jojotown-eng/mouse-robot/README.md

# mouse-robot
マイクロマウスで使用するデータを入れておくリポジトリ

### design
機体のcadデータを入れるファイル

### firmware
マウス内のプログラムデータを入れるフォルダ

### PCB
基板関連のデータを入れる
