jojotown-eng/mouse-robot/参考資料/4fe2ce75dccb81fe/マニュアル(途中)/プログラミングの実践応用編.pptx

## プログラミング

実践応用編

## ＋α

- 安定性の向上
壁切れでの補正
前壁制御
横壁による後offset補正
- 探索や最短走行をより早く
歩数マップの直進優先
パス圧縮(大回り)
パス圧縮(斜め走行)
既知区間加速
- わかりやすく便利に
ファイルの分割
構造体
モード決定の関数
Flashに壁情報を保存

## 安定性向上

## 安定性の向上 :壁切れでの補正

壁の切れ目を判定してターン前のoffsetを調整
壁が切れるまで進む→壁が切れたらそこから任意の距離進む
距離が足りない場合は壁が切れるまで進むで距離を増加させ、
距離が過ぎてる場合は壁が切れてからの距離のため距離が減少させる．

## 安定性の向上 :前壁制御

前センサの値を前壁との距離に変換し，一定の距離になったら曲がる

## 安定性の向上 :前壁制御

横センサの値を横壁との距離に変換し，その距離に応じて後オフセットの距離を変化させる

## 探索や最短走行をより早く

## Slide 8
