jojotown-eng/mouse-robot/参考資料/4fe2ce75dccb81fe/マニュアル(途中)/番外編_シルクでお絵かき.pptx

## 番外編

## Slide 2

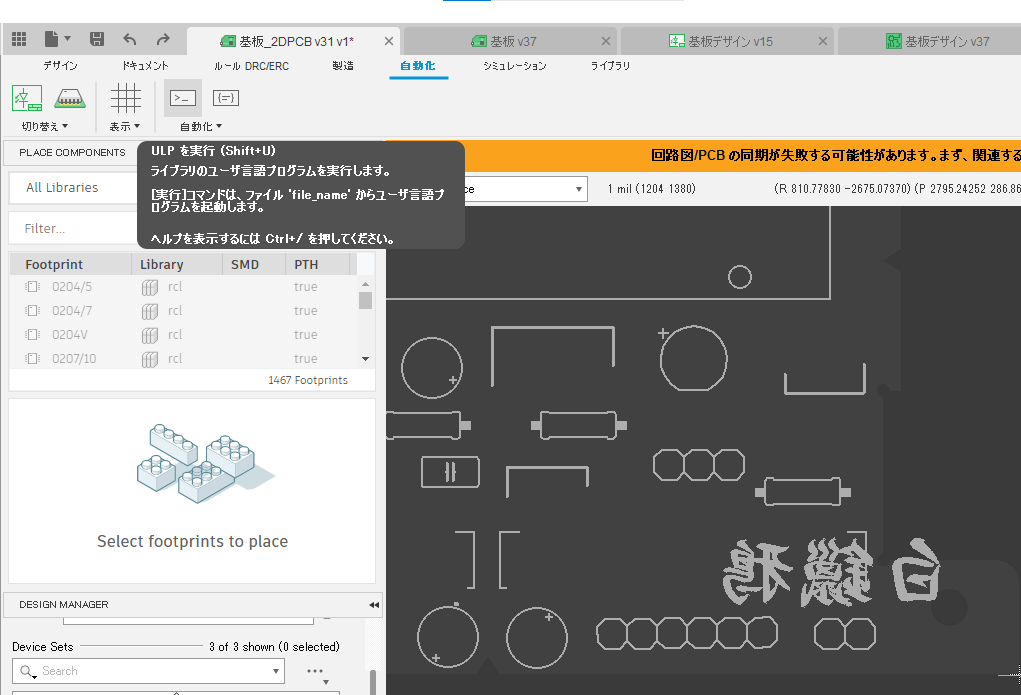
[picture p2: figure]

## Slide 3

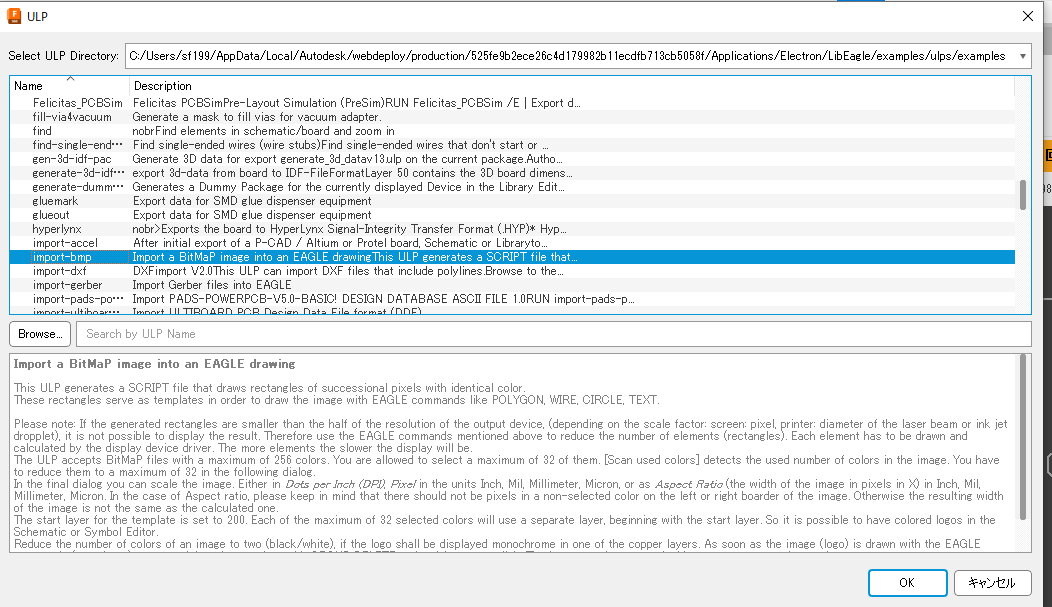
[picture p3: figure]

## Slide 4

二値化ファイル(BMP)を開く

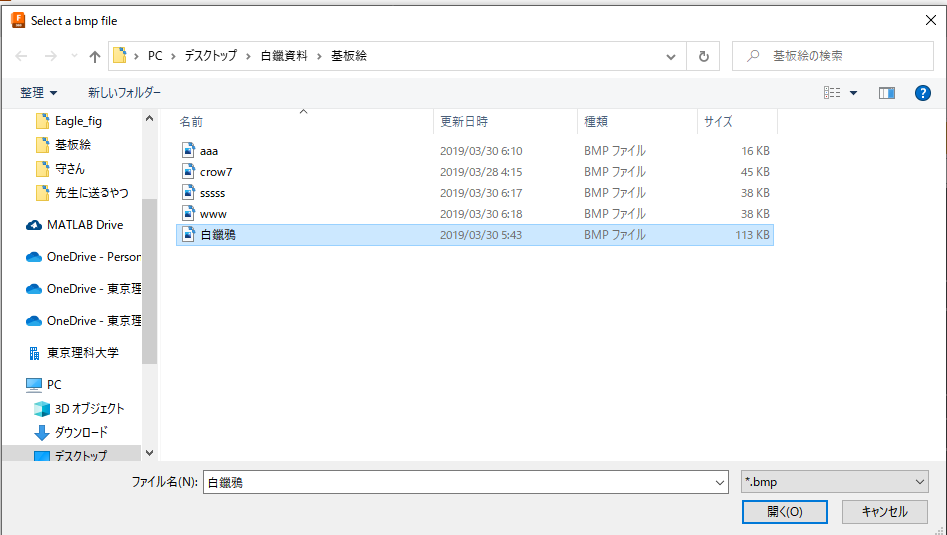
[picture p4: figure]

## Slide 5

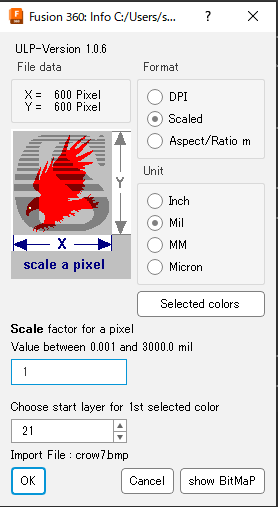
[picture p5: figure]

シルクを入れたい色を選ぶ

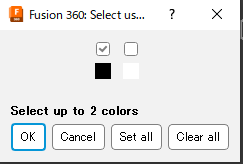
[picture p6: figure]

スケール(大きさ)
絵を入れるレイヤー(今回は表面ならtplaceの21,裏面ならbplaceの22)

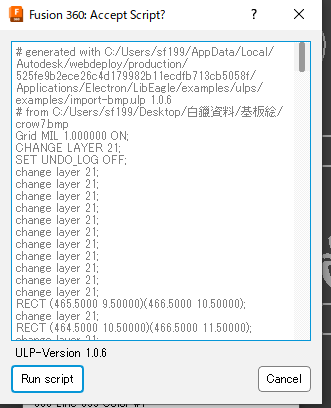
[picture p7: figure]

run
