jojotown-eng/mouse-robot/参考資料/下基板.dxf

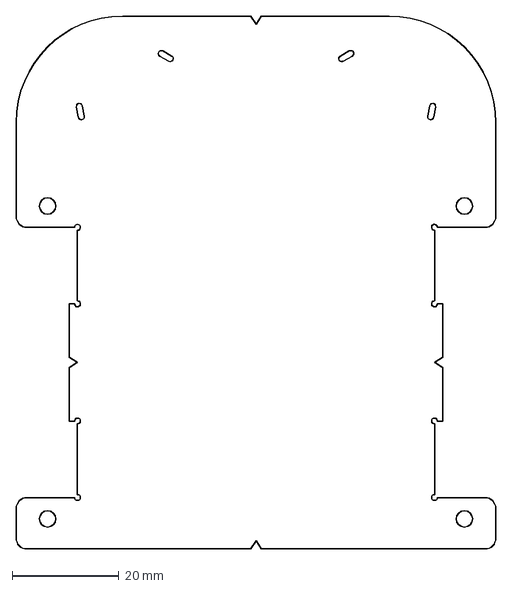
[picture p17: CAD file, 2024-09-20]
参考資料/下基板.dxf
90.0 x 100.0 mm
