jojotown-eng/mouse-robot/(list of files, cad)

Other CAD files:
参考資料/316592fce7f853e4.f3z
