jojotown-eng/mouse-robot/参考資料/v1.pdf

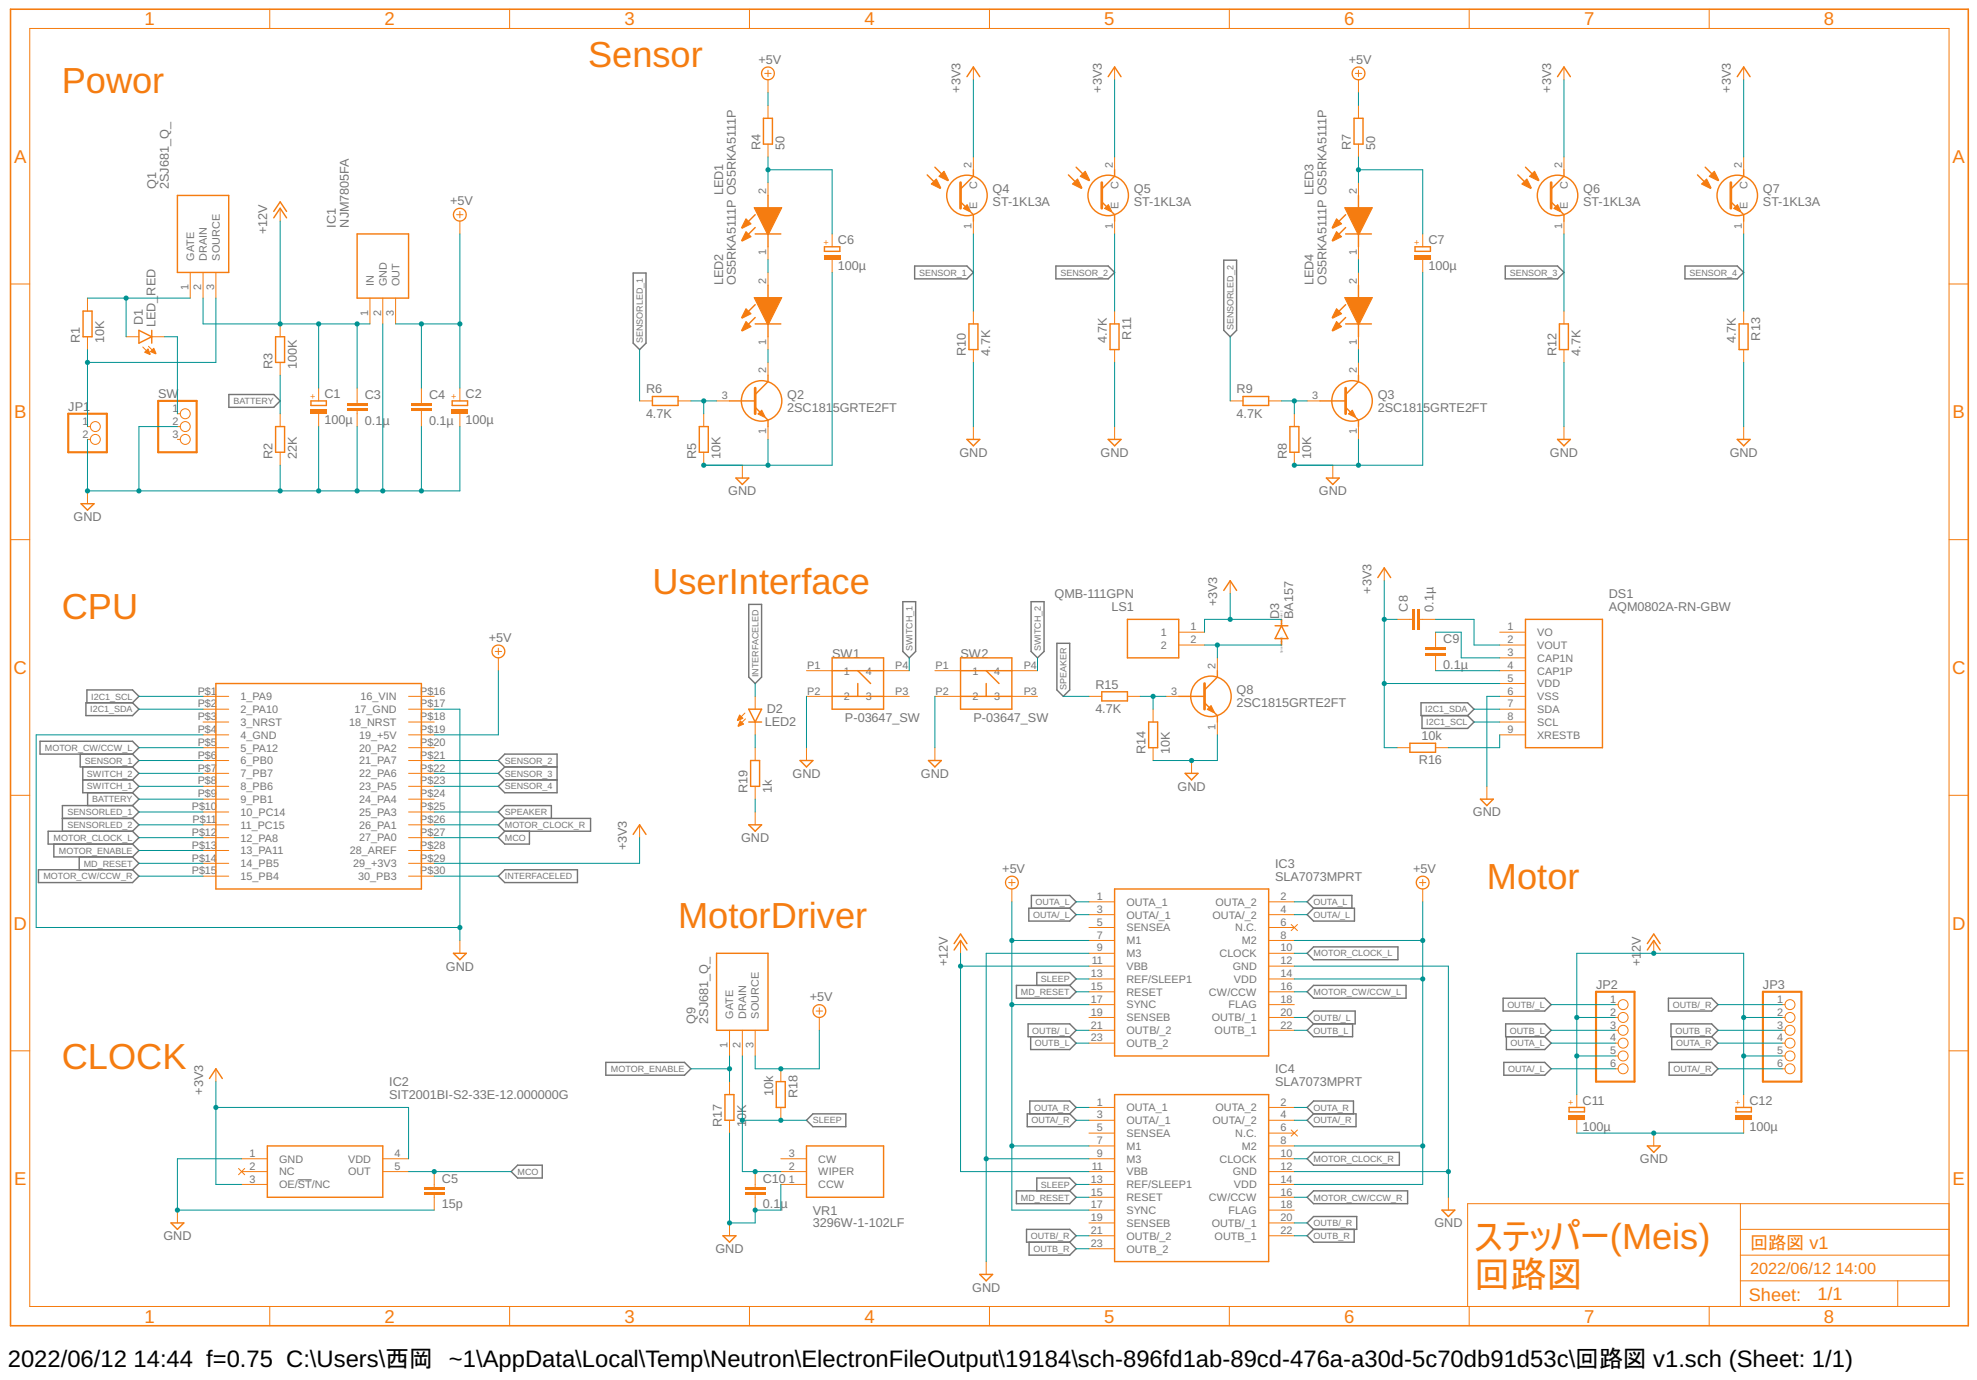
[picture p18: page 1]

Sensor +5V | | | +5V

2022/06/12 14:44 f=0.75 C:\Users\西岡 ~1\AppData\Local\Temp\Neutron\ElectronFileOutput\19184\sch-896fd1ab-89cd-476a-a30d-5c70db91d53c\回路図 v1.sch (Sheet: 1/1)
