jojotown-eng/mouse-robot/PCB/mouse_v1/mouse_v1.kicad_pcb

## KiCad design PCB/mouse_v1/mouse_v1.kicad_pcb (2024-11-23)

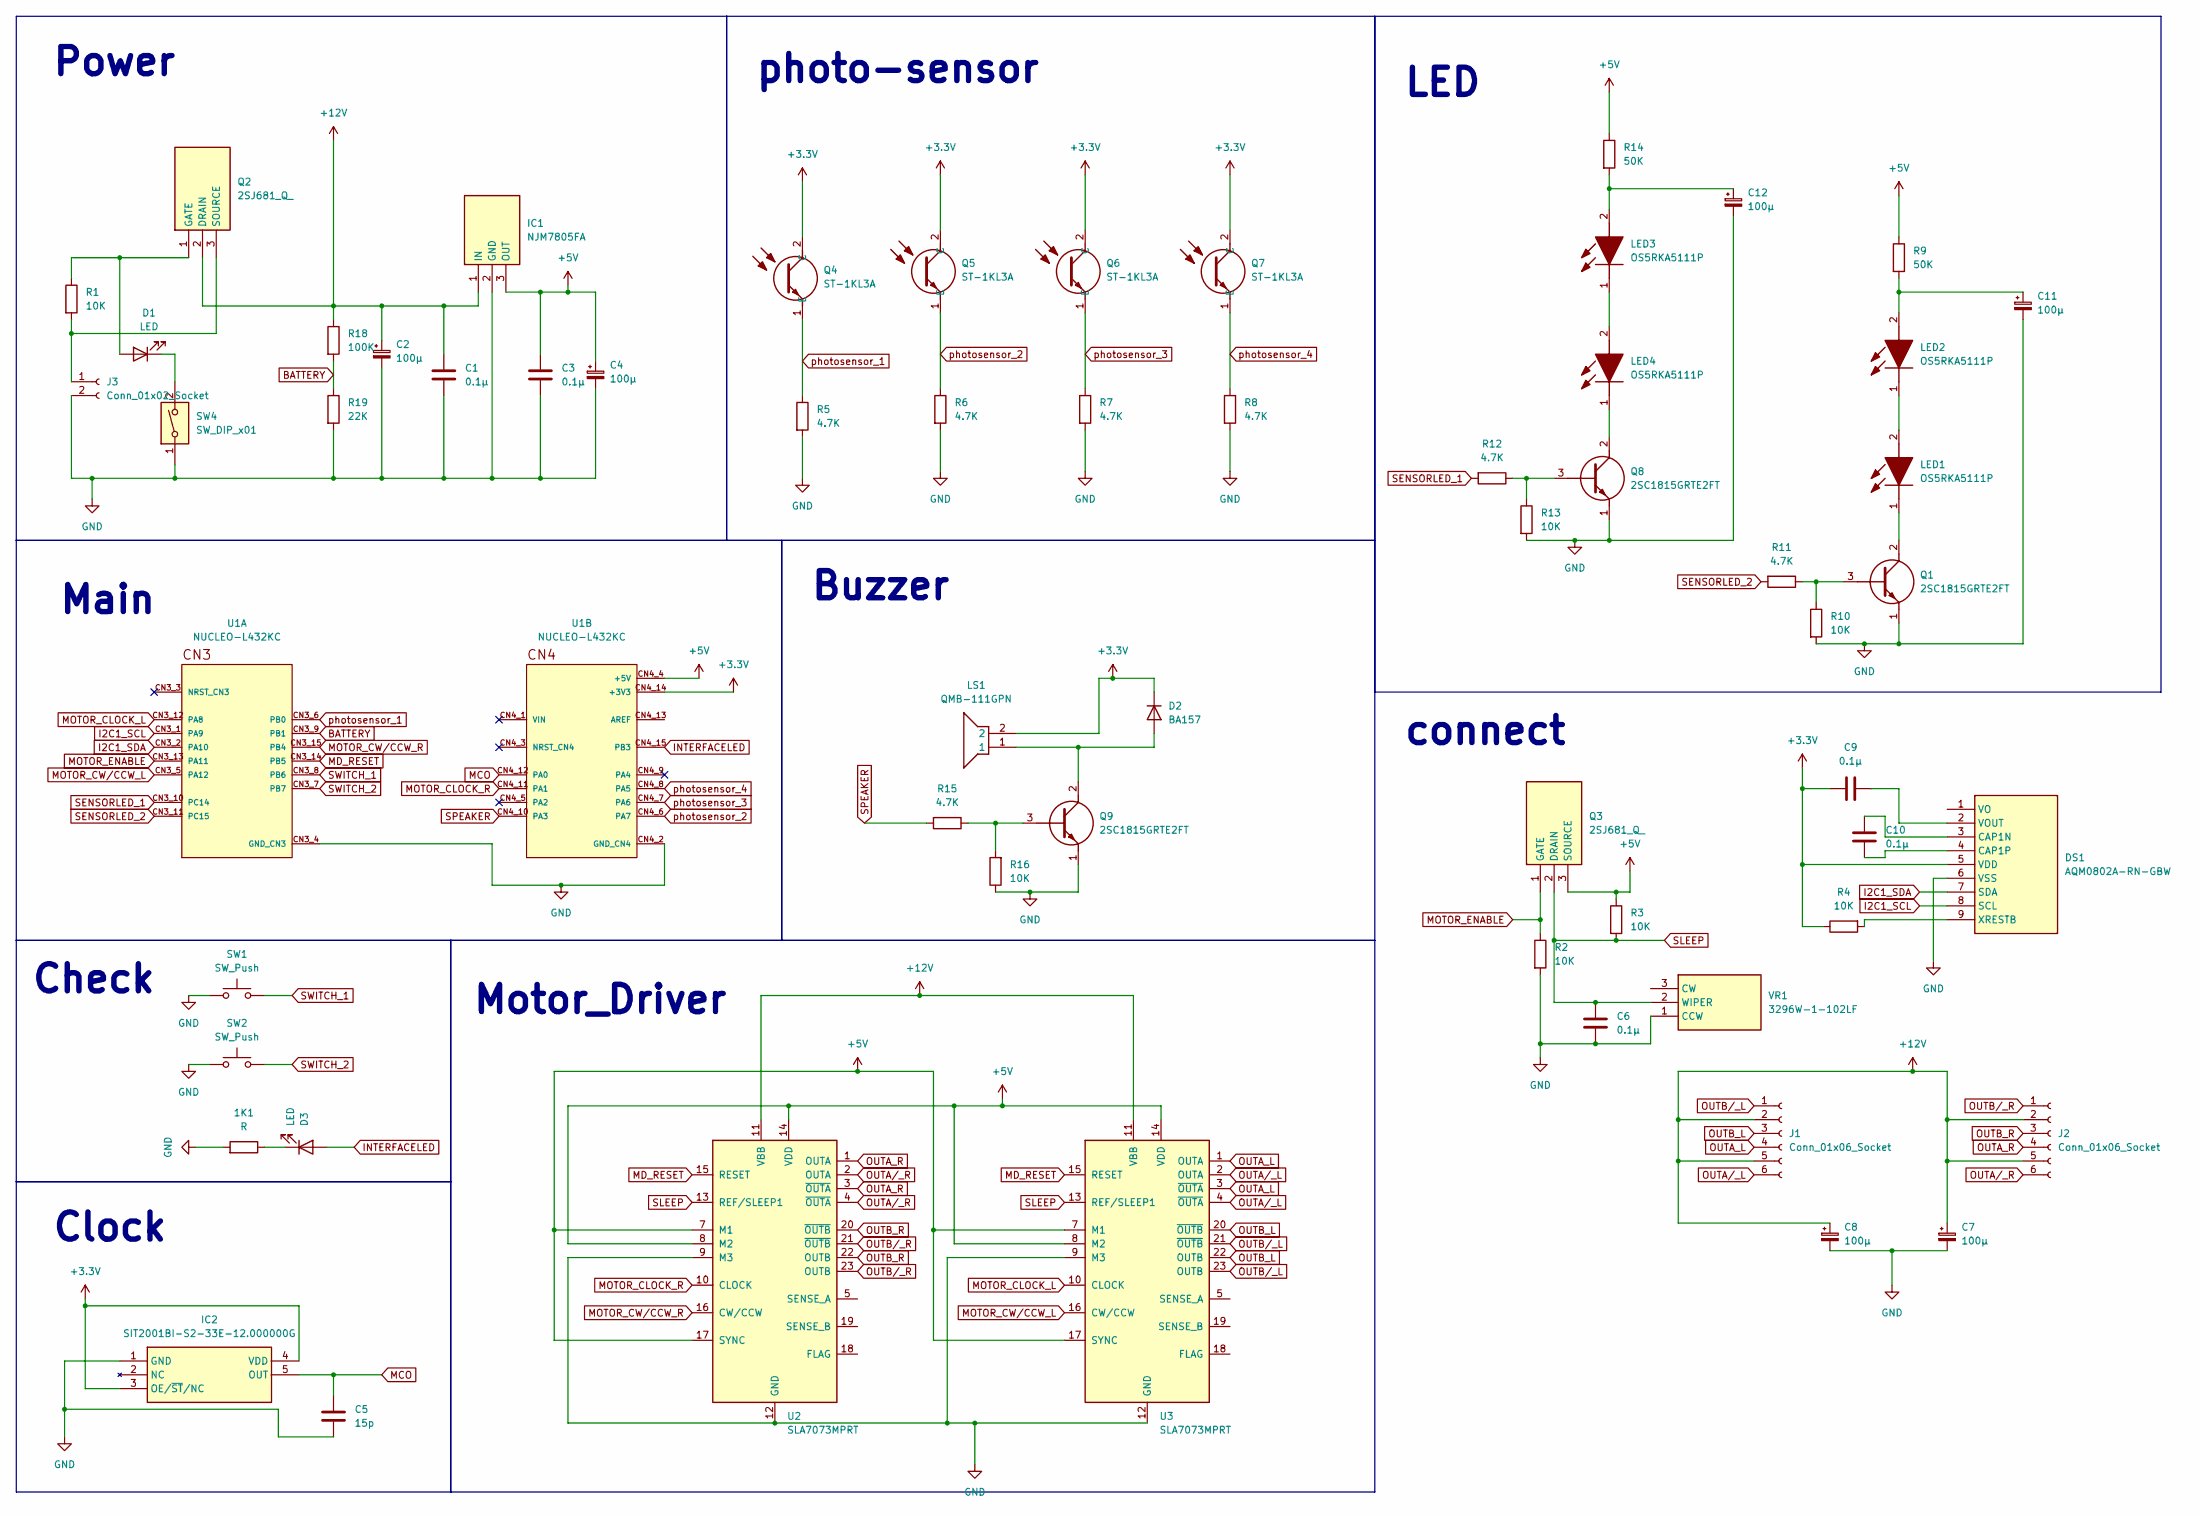
[picture p19: schematic mouse_v1.kicad_sch]

Parts:
1K1: R; R_0603_1608Metric_Pad0.98x0.95mm_HandSolder
C1, C3, C6, C9, C10: 0.1μ; C_0603_1608Metric
C2, C4, C7, C8, C11, C12: 100μ; CP_Radial_D6.3mm_P2.50mm
C5: 15p; C_0603_1608Metric
D1, D3: LED; LED_0603_1608Metric
D2: BA157; D_0603_1608Metric
DS1: AQM0802A-RN-GBW; AQM0802ARNGBW; Manufacturer_Part_Number AQM0802A-RN-GBW
IC1: NJM7805FA; TO254P500X1000X2170-3P; Manufacturer_Part_Number NJM7805FA
IC2: SIT2001BI-S2-33E-12.000000G; SOT95P280X130-5N; Manufacturer_Part_Number SIT2001BI-S2-33E-12.000000G
J1, J2: Conn_01x06_Socket; JST_XH_B6B-XH-A_1x06_P2.50mm_Vertical
J3: Conn_01x02_Socket; JST_XH_B2B-XH-A_1x02_P2.50mm_Vertical
LED1, LED2, LED3, LED4: OS5RKA5111P; Manufacturer_Part_Number OS5RKA5111P
LS1: QMB-111GPN; QMB111GPN; Manufacturer_Part_Number QMB-111GPN
Q1, Q8, Q9: 2SC1815GRTE2FT; SOT-23; Manufacturer_Part_Number 2SC1815GRTE2FT
Q2, Q3: 2SJ681_Q_; TO230P250X650X900-3P; Manufacturer_Part_Number 2SJ681(Q)
Q4, Q5, Q6, Q7: ST-1KL3A; ST1KL3A; Manufacturer_Part_Number ST-1KL3A
R1, R2, R3, R4, R10, R13, R16: 10K; R_0603_1608Metric_Pad0.98x0.95mm_HandSolder
R5, R6, R7, R8, R11, R12, R15: 4.7K; R_0603_1608Metric_Pad0.98x0.95mm_HandSolder
R9, R14: 50K; R_0603_1608Metric_Pad0.98x0.95mm_HandSolder
R18: 100K; R_0603_1608Metric_Pad0.98x0.95mm_HandSolder
R19: 22K; R_0603_1608Metric_Pad0.98x0.95mm_HandSolder
SW1, SW2: SW_Push; SW_PUSH_6mm_H7.3mm
SW4: SW_DIP_x01; SW_DIP_SPSTx01_Slide_9.78x4.72mm_W7.62mm_P2.54mm
U1: NUCLEO-L432KC; MODULE_NUCLEO-L432KC; PARTREV N/A
U2, U3: SLA7073MPRT
VR1: 3296W-1-102LF; 3296W1102LF; Manufacturer_Part_Number 3296W-1-102LF

Connections:
+3.3V: C9.1, D2.1 (K), DS1.5 (VDD), IC2.3 (OE/~ST/NC), IC2.4 (VDD), LS1.2, Q4.2 (C), Q5.2 (C), Q6.2 (C), Q7.2 (C), R4.1, U1.CN4_14 (+3V3)
+5V: C3.1, C4.1, IC1.3 (OUT), Q3.3 (SOURCE), R3.1, R9.1, R14.1, U1.CN4_4 (+5V), U2.7 (M1), U2.8 (M2), U2.14 (VDD), U2.17 (SYNC), U3.7 (M1), U3.8 (M2), U3.14 (VDD), U3.17 (SYNC)
+12V: C1.1, C2.1, C7.1, C8.1, IC1.1 (IN), J1.2, J1.5, J2.2, J2.5, Q2.2 (DRAIN), R18.1, U2.11 (VBB), U3.11 (VBB)
BATTERY: R18.2, R19.1, U1.CN3_9 (PB1)
GND: 1K1.2, C1.2, C2.2, C3.2, C4.2, C5.2, C6.2, C7.2, C8.2, C11.2, C12.2, DS1.6 (VSS), IC1.2 (GND), IC2.1 (GND), J3.2, Q1.1 (E), Q8.1 (E), Q9.1 (E), R2.2, R5.2, R6.2, R7.2, R8.2, R10.2, R13.2, R16.1, R19.2, SW1.1, SW2.1, SW4.1, U1.CN3_4 (GND_CN3), U1.CN4_2 (GND_CN4), U2.9 (M3), U2.12 (GND), U3.9 (M3), U3.12 (GND), VR1.1 (CCW)
I2C1_SCL: DS1.8 (SCL), U1.CN3_1 (PA9)
I2C1_SDA: DS1.7 (SDA), U1.CN3_2 (PA10)
INTERFACELED: D3.2 (A), U1.CN4_15 (PB3)
MCO: C5.1, IC2.5 (OUT), U1.CN4_12 (PA0)
MD_RESET: U1.CN3_14 (PB5), U2.15 (RESET), U3.15 (RESET)
MOTOR_CLOCK_L: U1.CN3_12 (PA8), U3.10 (CLOCK)
MOTOR_CLOCK_R: U1.CN4_11 (PA1), U2.10 (CLOCK)
MOTOR_CW/CCW_L: U1.CN3_5 (PA12), U3.16 (CW/CCW)
MOTOR_CW/CCW_R: U1.CN3_15 (PB4), U2.16 (CW/CCW)
MOTOR_ENABLE: Q3.1 (GATE), R2.1, U1.CN3_13 (PA11)
unnamed: D1.2 (A), Q2.1 (GATE), R1.1
unnamed: D1.1 (K), SW4.2
unnamed: D2.2 (A), LS1.1, Q9.2 (C)
unnamed: 1K1.1, D3.1 (K)
unnamed: C10.2, DS1.3 (CAP1N)
unnamed: C10.1, DS1.4 (CAP1P)
unnamed: C9.2, DS1.2 (VOUT)
unnamed: DS1.9 (XRESTB), R4.2
unnamed: J3.1, Q2.3 (SOURCE), R1.2
unnamed: LED1.2 (A), LED2.1 (K)
unnamed: LED1.1 (K), Q1.2 (C)
unnamed: C11.1, LED2.2 (A), R9.2
unnamed: C12.1, LED3.2 (A), R14.2
unnamed: LED3.1 (K), LED4.2 (A)
unnamed: LED4.1 (K), Q8.2 (C)
unnamed: Q1.3 (B), R10.1, R11.1
unnamed: Q8.3 (B), R12.1, R13.1
unnamed: Q9.3 (B), R15.1, R16.2
OUTA_L: J1.4, U3.1 (OUTA), U3.3 (~OUTA)
OUTA_R: J2.4, U2.1 (OUTA), U2.3 (~OUTA)
OUTA/_L: J1.6, U3.2 (OUTA), U3.4 (~OUTA)
OUTA/_R: J2.6, U2.2 (OUTA), U2.4 (~OUTA)
OUTB_L: J1.3, U3.20 (~OUTB), U3.22 (OUTB)
OUTB_R: J2.3, U2.20 (~OUTB), U2.22 (OUTB)
OUTB/_L: J1.1, U3.21 (~OUTB), U3.23 (OUTB)
OUTB/_R: J2.1, U2.21 (~OUTB), U2.23 (OUTB)
SENSORLED_1: R12.2, U1.CN3_10 (PC14)
SENSORLED_2: R11.2, U1.CN3_11 (PC15)
SLEEP: C6.1, Q3.2 (DRAIN), R3.2, U2.13 (REF/SLEEP1), U3.13 (REF/SLEEP1), VR1.2 (WIPER)
SPEAKER: R15.2, U1.CN4_10 (PA3)
SWITCH_1: SW1.2, U1.CN3_8 (PB6)
SWITCH_2: SW2.2, U1.CN3_7 (PB7)
photosensor_1: Q4.1 (E), R5.1, U1.CN3_6 (PB0)
photosensor_2: Q5.1 (E), R6.1, U1.CN4_6 (PA7)
photosensor_3: Q6.1 (E), R7.1, U1.CN4_7 (PA6)
photosensor_4: Q7.1 (E), R8.1, U1.CN4_8 (PA5)

Notes on the sheet:
photo-sensor
Check
Power
connect
Buzzer
Motor_Driver
Main
LED
Clock

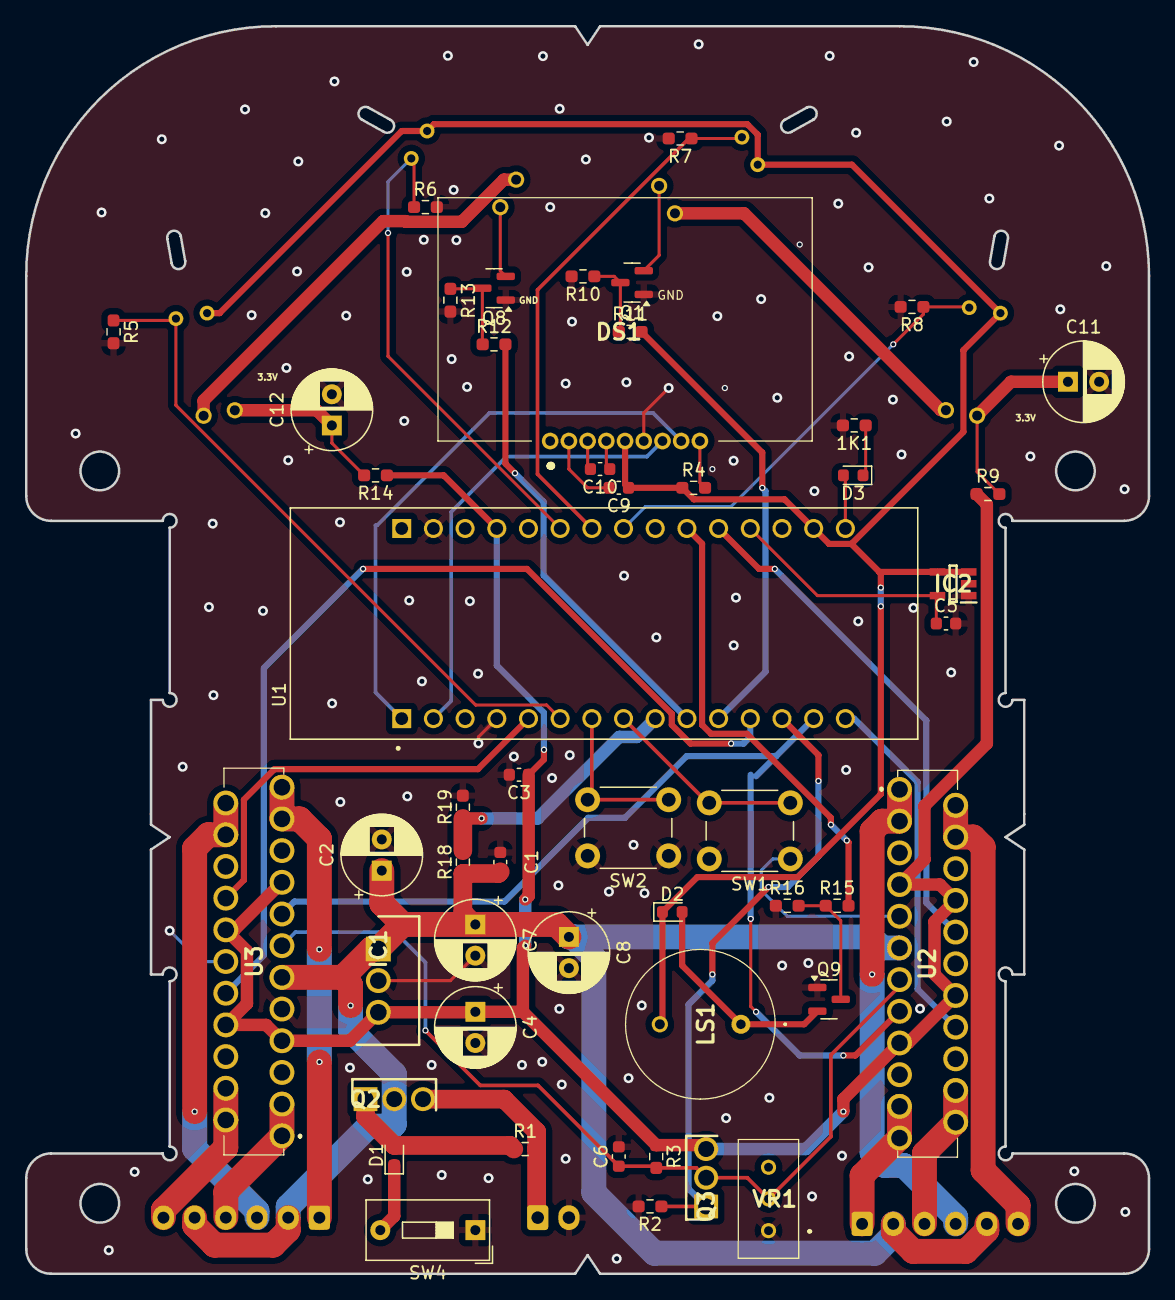
[picture p20: board mouse_v1.kicad_pcb from above]

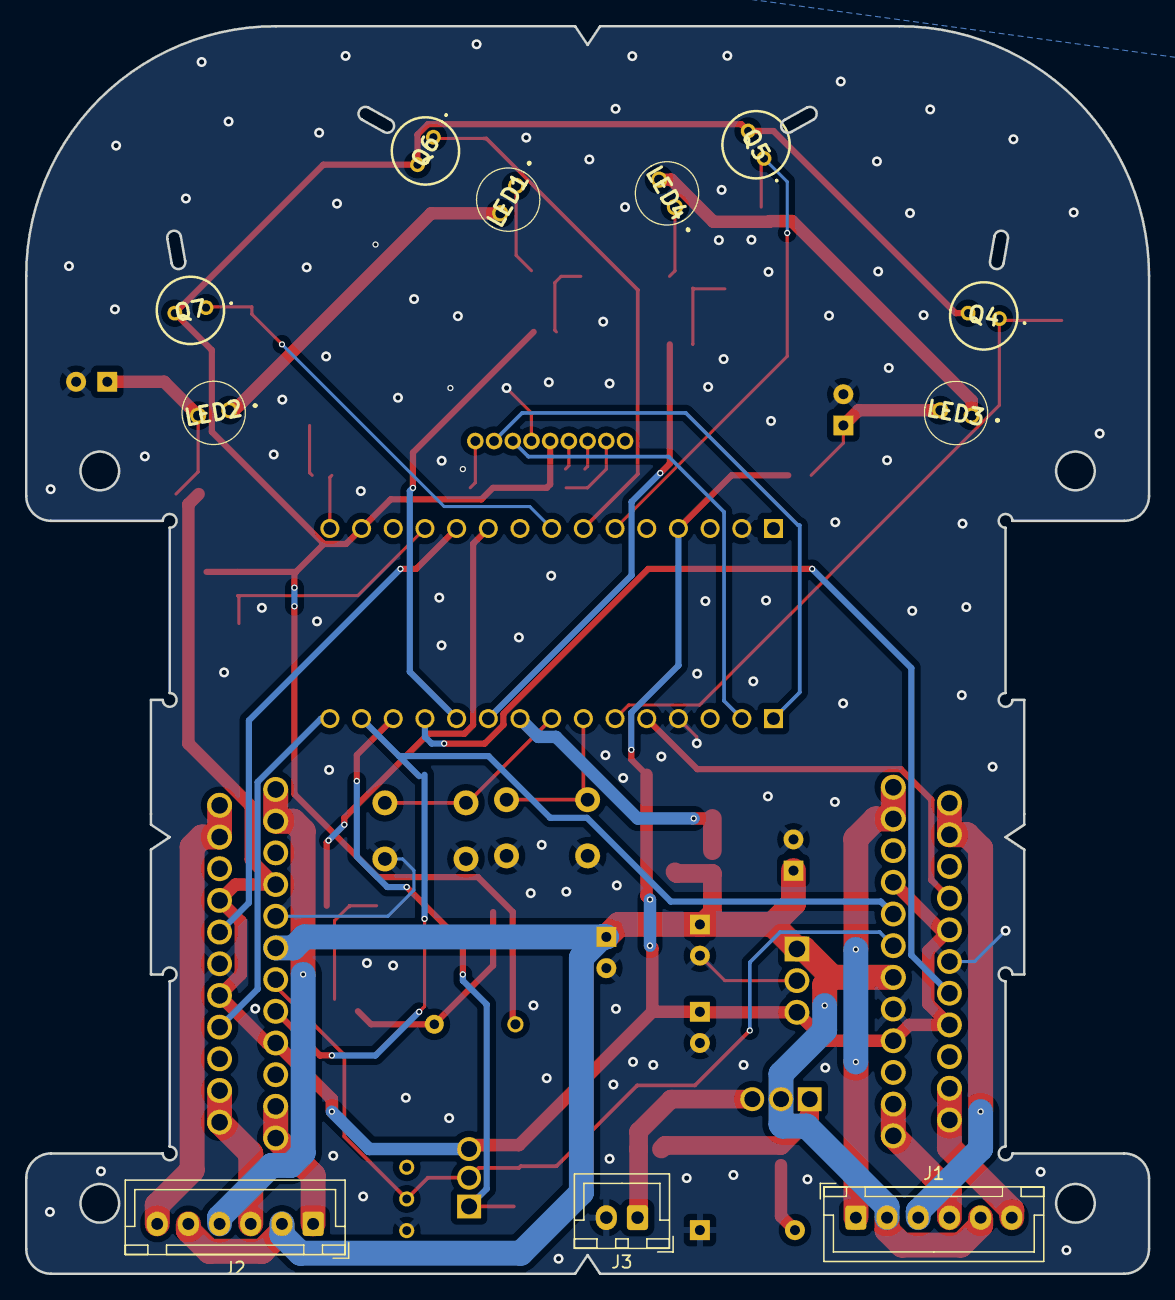
[picture p21: board mouse_v1.kicad_pcb from below]

Board: 2 copper layers, 90.0 x 100.0 mm, 61 parts (11 on the bottom side), 51 nets.
