jojotown-eng/mouse-robot/firmware/firmware.ioc

Mcu.UserName=STM32L432KCUx
PA10.GPIO_Label=switch
PA10.Signal=GPIO_Input
PA11.Signal=CAN1_RX
PA12.Signal=CAN1_TX
PA2.Signal=USART2_TX
PA3.Signal=USART2_RX
PA8.Signal=SWPMI1_IO
PA9.Signal=GPIO_Output
