jojotown-eng/mouse-robot/firmware/Core/Inc/main.h

#define switch_Pin GPIO_PIN_10
#define switch_GPIO_Port GPIOA
#define LED_Pin GPIO_PIN_3
#define LED_GPIO_Port GPIOB
