jojotown-eng/mouse-robot/firmware/include/mainpp.h

#ifndef BURGER_COOKER_DC_MOTOR_DIVER_APP_APP_H_
#define BURGER_COOKER_DC_MOTOR_DIVER_APP_APP_H_

#ifdef __cplusplus
extern "C" {
#endif

#include "main.h"

void mainsetup(void);
void maintask(void);

#ifdef __cplusplus
}
#endif 

#endif //BURGER_COOKER_DC_MOTOR_DIVER_APP_APP_H_
