jojotown-eng/mouse-robot/(commit log)

2024-08-22 Kicadの新規ファイル追加
    [mouse_v1.kicad_pcb, mouse_v1.kicad_sch]
2024-08-22 soramouse参考プログラム
2024-08-22 須田先輩から頂いた資料
    [316592fce7f853e4.f3z]
2024-08-25 フットプリントライブラリーの追加
2024-08-31 main,motor_driver,connect,clockの回路図作成
    [mouse_v1.kicad_sch]
2024-09-05 回路図のデータ作成終了,名前振り開始
    [mouse_v1.kicad_sch]
2024-09-09 回路図の名前振り終了
    [mouse_v1.kicad_sch]
2024-09-09 capactorを適当にフットプリント振った
    [mouse_v1.kicad_sch]
2024-09-19 フットプリントを途中まで割り当てて,外部からインポートした部品はできていない
    [mouse_v1.kicad_pcb, mouse_v1.kicad_sch]
2024-09-20 基板のフットプリント完了
    [mouse_v1.kicad_pcb, mouse_v1.kicad_sch, 下基板.dxf]
2024-09-20 READMEの編集を行った
2024-09-22 抵抗やコンデンサに具体的な値を明示した
    [mouse_v1.kicad_sch]
2024-09-23 配線完了,元のデータはsensorLEDのフラグの値が両方1になっていた
    [mouse_v1.kicad_pcb]
2024-09-23 README少し変更した
2024-09-28 アートワークを部品ごとに区分けした
    [mouse_v1.kicad_pcb]
2024-09-28 配線が短くなるように配線した,I2Cは長くなった
    [mouse_v1.kicad_pcb]
2024-09-28 配線完了した(埋め込んだcadがおかしいかも)
    [mouse_v1.kicad_pcb]
2024-09-30 穴の位置に備品があったから少し配置を変えた
    [mouse_v1.kicad_pcb]
2024-10-03 残りのコミット
2024-11-09 配線完了(仮)
    [mouse_v1.kicad_pcb, mouse_v1.kicad_sch]
2024-11-09 基板完成
    [mouse_v1.kicad_pcb]
2024-11-09 未配線部分を配線した
2024-11-18 再配線完了
    [mouse_v1.kicad_pcb]
2024-11-23 LEDのコンデンサ部分の配線を太くした
    [mouse_v1-B_Paste.gbr, mouse_v1-B_Silkscreen.gbr, mouse_v1-Edge_Cuts.gbr, mouse_v1-F_Paste.gbr, mouse_v1-F_Silkscreen.gbr, mouse_v1-NPTH.drl, mouse_v1-PTH.drl, mouse_v1-job.gbrjob]
2025-02-19 ファイルを開いたせいで起きた変更
2025-02-22 コードを生成した(LEDの実験のため)
2025-02-22 Lチカできた
2025-02-22 Revert "Lチカできた"
    This reverts commit e3f75234c185cfba6b6a0cced84f349a181752c7.
2025-03-01 環境設定をしてビルドまではした。動作しない原因を特定しないと
2025-04-05 スイッチのクラス部分を追加した
